vuoz/zongle/zongle.kicad_pcb

## KiCad design zongle.kicad_pcb (2025-12-17)

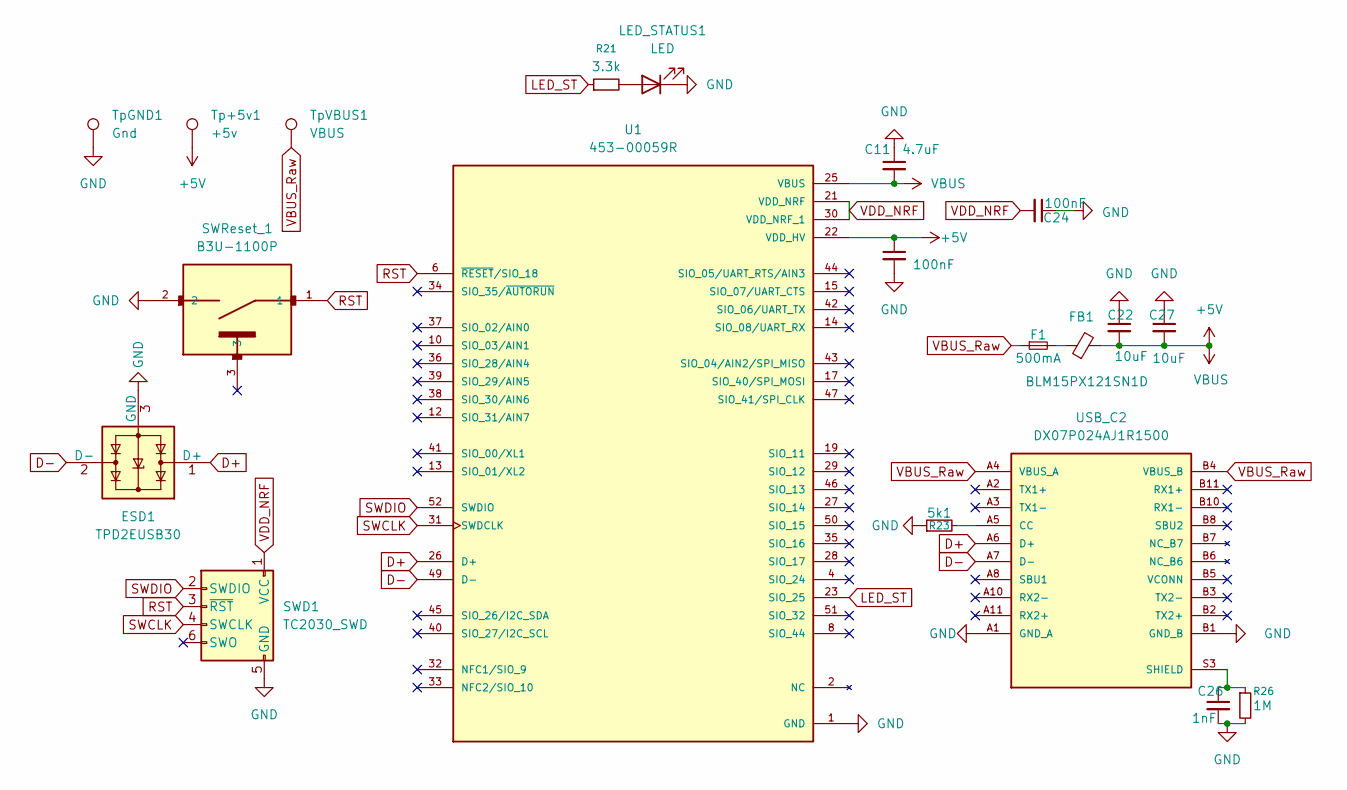
[picture p1: schematic zongle.kicad_sch]

Parts:
C11: 4.7uF; C_0402_1005Metric
C22, C27: 10uF; C_0402_1005Metric
C23, C24: 100nF; C_0402_1005Metric
C26: 1nF; C_0402_1005Metric
ESD1: TPD2EUSB30; Texas_DRT-3
F1: 500mA; Fuse_0402_1005Metric
FB1: BLM15PX121SN1D; R_0402_1005Metric
LED_STATUS1: LED; LED_0402_1005Metric
R21: 3.3k; R_0201_0603Metric
R23: 5k1; R_0201_0603Metric
R26: 1M; R_0201_0603Metric
SWD1: TC2030_SWD; CON_TC2030_outlined
SWReset_1: B3U-1100P; SW_SPST_B3U-1000P
Tp+5v1: +5v; TestPoint_Pad_1.0x1.0mm
TpGND1: Gnd; TestPoint_Pad_1.0x1.0mm
TpVBUS1: VBUS; TestPoint_Pad_1.0x1.0mm
U1: 453-00059R; BL653_59; PARTREV 1.5
USB_C2: DX07P024AJ1R1500; USB_C_MALE_LONG; PARTREV January 2016; DigiKey_Part_Number 670-2868-1-ND

Connections:
+5V: C11.2, C22.2, C23.1, C27.2, FB1.2, Tp+5v1.1, U1.22 (VDD_HV), U1.25 (VBUS)
D+: ESD1.1 (D+), U1.26 (D+), USB_C2.A6 (D+)
D-: ESD1.2 (D-), U1.49 (D-), USB_C2.A7 (D-)
GND: C11.1, C22.1, C23.2, C24.1, C26.2, C27.1, ESD1.3 (GND), LED_STATUS1.1 (K), R23.1, R26.2, SWD1.5 (GND), SWReset_1.2, TpGND1.1, U1.1 (GND), U1.3 (GND), U1.5 (GND), U1.7 (GND), U1.9 (GND), U1.11 (GND), U1.16 (GND), U1.18 (GND), U1.20 (GND), U1.24 (GND), U1.48 (GND), U1.G1 (GND), U1.G2 (GND), U1.G3 (GND), U1.G4 (GND), U1.G5 (GND), U1.G6 (GND), U1.G7 (GND), USB_C2.A1 (GND_A), USB_C2.A12 (GND_A), USB_C2.B1 (GND_B), USB_C2.B12 (GND_B)
LED_ST: R21.1, U1.23 (SIO_25)
unnamed: C26.1, R26.1, USB_C2.S3 (SHIELD), USB_C2.S4 (SHIELD), USB_C2.S5 (SHIELD), USB_C2.S6 (SHIELD)
unnamed: F1.2, FB1.1
unnamed: LED_STATUS1.2 (A), R21.2
unnamed: R23.2, USB_C2.A5 (CC)
RST: SWD1.3 (~RST), SWReset_1.1, U1.6 (~RESET/SIO_18)
SWCLK: SWD1.4 (SWCLK), U1.31 (SWDCLK)
SWDIO: SWD1.2 (SWDIO), U1.52 (SWDIO)
VBUS_Raw: F1.1, TpVBUS1.1, USB_C2.A4 (VBUS_A), USB_C2.A9 (VBUS_A), USB_C2.B4 (VBUS_B), USB_C2.B9 (VBUS_B)
VDD_NRF: C24.2, SWD1.1 (VCC), U1.21 (VDD_NRF), U1.30 (VDD_NRF_1)

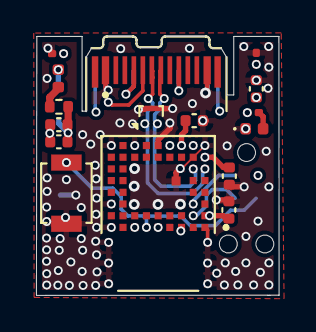
[picture p2: board zongle.kicad_pcb from above]

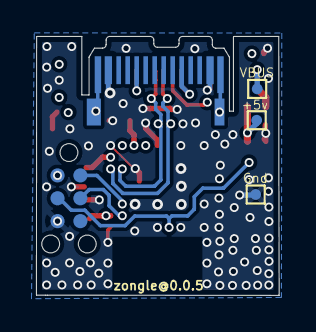
[picture p3: board zongle.kicad_pcb from below]

Board: 6 copper layers, 13.5 x 14.4 mm, 20 parts (4 on the bottom side), 14 nets.
