vuoz/zongle/(commit log)

2025-12-03 first draft of schematic
    [zongle.kicad_pcb, zongle.kicad_sch]
2025-12-04 draft of layout
    [zongle.kicad_pcb, zongle.kicad_sch]
2025-12-06 further routing. still missig footprints for testpoints and reset button, most of the routing is now done, will need some cleanup + drc fixesw
    [zongle.kicad_pcb, zongle.kicad_sch]
2025-12-07 used actual symbol of usb c port. redid routing. saved 2mm in length. fixed 3d model for usb c receptacle, now using 6 layers for cheap via in pad to avoid having to pay for microvias
    [zongle.kicad_pcb, zongle.kicad_sch]
2025-12-08 some layout changes. fixed testpoint size. found fitting reset button. moved all parts to the top side, now missing part asignment
    [zongle.kicad_pcb, zongle.kicad_sch]
2025-12-08 some routing cleanup, some drc fixes, assigned parts to every footprint
    [zongle.kicad_pcb, zongle.kicad_sch]
2025-12-08 minor changes to the routing. final tweaks for first version
    [zongle.kicad_pcb, zongle.kicad_sch]
2025-12-08 added version indicator on pcb
    [zongle.kicad_pcb]
2025-12-09 moved some components furhter from the antenna, modified usb testpoints to be smaller and not interfere with the signal (hopefully :o ), changed track width to 0.2mm on most components to avoid produ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
    [zongle.kicad_pcb]
2025-12-10 some tweaks to usb routing. move power cap closer to vdd
    [zongle.kicad_pcb]
2025-12-10 linked model for 453-00059 nrf52833 module, later will move all the modules to the project repo, so that using this on another device is possible without new linking of the models
    [zongle.kicad_pcb, zongle.kicad_sch]
2025-12-10 minor changes
    [zongle.kicad_pcb]
2025-12-11 moved all power traces to inner layers. added some via stitching
    [zongle.kicad_pcb]
2025-12-11 some more cleanup. changed zone fill properties to match design requirements. moved led trace to power layer, more via stitching
    [zongle.kicad_pcb]
2025-12-11 moved led outside of antenna perimeter just to be extra sure. some via stitching + cleanup
    [zongle.kicad_pcb, zongle.kicad_sch]
2025-12-11 moved testpad for 5v to allow via in pad for decoupeling cap instead of trace to a far away via
    [zongle.kicad_pcb]
2025-12-11 removed usb testpoints
    [zongle.kicad_pcb, zongle.kicad_sch]
2025-12-11 cleaned usb traces. moved esd closer to usb
    [zongle.kicad_pcb, zongle.kicad_sch]
2025-12-12 moved testpoints
    [zongle.kicad_pcb]
2025-12-16 some routing refinements. moved all components as far away from the antenna as possible. added another decup cap to the power path. changed board thickness to 0.8mm to accomodate for usb-c plug. some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
    [zongle.kicad_pcb, zongle.kicad_sch]
2025-12-17 changes version number to 0.0.5
    [zongle.kicad_pcb]
2025-12-17 moved via minimally
    [zongle.kicad_pcb]
